mlumobi/uwm-indoor-localization-project/README.md

# UWB TDoA Real-time Localization

An EC601 course project to build and evaluate an indoor location system for tagged objects using ultra wideband (UWB) radio and uplink time difference of arrival (TDoA).

This is a one-person project. Mingjin Lu is responsible for hardware integration, firmware, localization software, evaluation, and documentation, with AI assistance.

**Status:** Proposal stage. This repository currently contains the project proposal and reference documents. Firmware, localization software, and measured performance results are not yet included. Accuracy, update rate, and reliability values below are proposed targets, not demonstrated capabilities.

## Five Ws and How

| Question | Project definition |
| --- | --- |
| **What** | An indoor monitoring prototype for tagged robots and vehicles, with a live 2D map, distinct tag IDs, position freshness and validity indicators, configurable safety zones, alerts for non-permitted zone entry, abnormal motion and prolonged signal loss, and recorded-movement replay. The physical prototype targets two tags and three anchors; additional tags may be simulated and clearly labeled. |
| **Who** | The primary target user is a warehouse or factory safety manager overseeing a shared workspace with vehicles, people, robots, and machinery. A robotics engineer also needs to monitor a robot without integrating with its onboard navigation software. Mingjin Lu is the sole developer, with AI assistance; user needs and interface usefulness still require interviews. |
| **Why** | Help the user see where tagged robots or vehicles are, recognize restricted-zone entries and unreliable tracking information, and review past movement. Evaluate these monitoring functions against measured ground truth and scripted scenarios; improved workplace safety and attack detection are not established outcomes. |
| **When** | The Sprint 1 two-week demo will show a labeled Python simulation, purchase and delivery progress, and the hardware implementation plan. After parts arrive, bring up the hardware, validate anchor clock correction, demonstrate one physical tag, then add the second tag and evaluate tracking and alerts. |
| **Where** | The intended application is a shared warehouse or factory workspace. Initial physical evaluation will use a controlled, surveyed indoor test area with known tag height and mapped zone boundaries; assembly and electrical checks are planned at RASTIC. Industrial deployment requires separate validation. |
| **How** | Start with simulated UWB arrival timestamps to test localization, map display, alerts, and replay. For hardware, use DWM3000 modules with XIAO ESP32C3 controllers: tags broadcast uplink blinks, three anchors record receive timestamps, and a computer corrects anchor clocks using periodic anchor-to-anchor UWB two-way exchanges, calculates TDoA positions, and applies the monitoring rules. Wi-Fi forwards records. Retain position and alert logs, compare accuracy and delay with ground truth, and use tag-to-anchor TWR as the fallback if clock correction fails its timing criteria. |

## Planned demonstration

- Two tags and three fixed anchors, each using a DWM3000 UWB module with an ESP32 or another compatible microcontroller.
- A controlled 2D test area with surveyed anchor positions and known tag height.
- Wi-Fi forwarding of timestamp records to a central computer; Bluetooth remains an option to evaluate.
- A live map with tag IDs, position age, and invalid or stale states.
- Raw measurement logs and replayable evaluation results.

Qorvo lists the DWM3000 for TWR and TDoA tag or anchor use, with a customer-supplied MCU. The module does not integrate Bluetooth, so any Bluetooth connection must come from another component. These specifications support the proposed architecture but do not establish this prototype’s performance. [Qorvo DWM3000](https://www.qorvo.com/products/p/DWM3000)

## Localization architecture

```text
Two UWB tags
    │ UWB broadcasts with tag ID and sequence number
    v
Three fixed anchors
    │ Hardware arrival timestamps and receive diagnostics
    │ Wi-Fi backhaul
    v
Central computer
    Clock correction -> frame matching -> TDoA solver -> map and logs
```

In uplink TDoA, anchors observe the same tag transmission. Differences in its arrival times correspond to differences in path lengths. Anchor clock synchronization or correction is essential; Wi-Fi or Bluetooth transports the records and does not, by itself, establish the required UWB timing basis. The proposed records therefore contain **arrival timestamps**, rather than independently measured tag-to-anchor distances. [ESP32 and DWM3000 study](https://arxiv.org/html/2403.10194v1)

**Recommended first experiment:** Verify that the selected boards and driver can produce consistent, corrected timestamps before building the full interface. A published ESP32/DWM3000 system uses two-way ranging (TWR); it provides hardware precedent but does not validate my uplink TDoA design. TWR may serve as a hardware baseline or an explicitly labeled fallback. [ESP32 and DWM3000 study](https://arxiv.org/html/2403.10194v1)

Three anchors provide two independent time differences for a known-height 2D model. This is a minimal configuration with no extra measurement redundancy; it does not guarantee a unique or well-conditioned position. A fourth anchor is a recommended improvement if resources allow. Anchor placement and obstructed radio paths must be evaluated because both affect TDoA localization quality. [Sensor placement study](https://arxiv.org/abs/2204.04508)

## Proposed evaluation targets

These targets require confirmation after user interviews and the initial timing experiment.

| Measure | Proposed criterion |
| --- | --- |
| Static horizontal accuracy | Median error ≤0.30 m and 95th-percentile error ≤0.75 m across nine surveyed test positions. |
| Valid-position ratio | At least 95% of scheduled tag transmissions produce accepted positions, reported separately for each tag. |
| Tag transmission rate | Start at 10 Hz per tag and report the achieved valid-position update rate. |
| Stale-state detection | Mark a position stale within one second of the last accepted estimate. |
| Reproducibility | A reviewer can replay retained records and reproduce the reported metrics using the documentation. |

Calibration and evaluation data should be separated. Report missed transmissions, rejected estimates, per-position errors, and obstructed-path results. Human tracking, robot control, free-height 3D localization, and industrial deployment remain outside the initial demonstration.

## Development plan

1. Interview prospective users, confirm hardware and course dates, and test a paper map.
2. Verify board communication and anchor clock correction; create a clearly labeled recorded-data demo.
3. Demonstrate one live tag end to end, then evaluate the surveyed area.
4. Add the second tag and test identity, update behavior, and failure states.
5. Publish reproducible measurements and document failed criteria and limitations.

The proposal contains five user stories with acceptance criteria, an INVEST review, thin demo slices, and ranked assumptions with tests and pivot criteria. No feasibility test results are available yet.

## Repository contents

```text
README.md
proposal/
    UWB_Project_Proposal.docx
    UWB_Project_Proposal.pdf
ref/
    DWM3000 Data Sheet.pdf
    HID-whitepaper-UWB-guide-for-decision-makers.pdf
    qorvo-getting-back-to-basics-with-ultra-wideband-uwb-white-paper.pdf
```

- [Project proposal — Word](proposal/UWB_Project_Proposal.docx)
- [Project proposal — PDF](proposal/UWB_Project_Proposal.pdf)
- [DWM3000 data sheet](ref/DWM3000%20Data%20Sheet.pdf)
- [HID UWB whitepaper](ref/HID-whitepaper-UWB-guide-for-decision-makers.pdf)
- [Qorvo — Getting Back to Basics with Ultra-Wideband (UWB)](ref/qorvo-getting-back-to-basics-with-ultra-wideband-uwb-white-paper.pdf)

The HID whitepaper is retained as a background reference; it was not used as evidence in the current proposal. Setup and execution instructions will be added when runnable software is available.

## Sources and course guide

- [EC601_Sprint1](https://docs.google.com/presentation/d/1xGqi0pRQQJJB1kcCf-J-DX_ZKf9MRdXoSHOy6zalLVk/edit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) — recurring reference for this project's Sprint 1 plan. When referring to the "Sprint 1 slides" or "EC601_Sprint1," use this deck. Slide 2 lists the required plan sections, including the primary target user.
- [EC601 Defining Your Project](https://docs.google.com/presentation/d/1mjnqe2xNa9wXm628SlQiQ_eo9ZSn7dLjxyB_iZE9pWU/edit) — project definition, mission, users, stories, INVEST, thin slicing, and assumption testing.
- [Qorvo DWM3000 product information](https://www.qorvo.com/products/p/DWM3000) — component capabilities and intended applications.
- [Qorvo, Getting Back to Basics with Ultra-Wideband (UWB), May 2021](ref/qorvo-getting-back-to-basics-with-ultra-wideband-uwb-white-paper.pdf) — manufacturer white paper explaining UWB timing principles and TWR, TDoA, reverse TDoA, and PDoA topologies. Its TDoA discussion informs the planned synchronized-anchor architecture; general performance claims do not establish this prototype's accuracy, update rate, or battery life.
- [Espressif ESP32-C3 Series Datasheet](https://www.espressif.com/sites/default/files/documentation/esp32-c3_datasheet_en.pdf) — MCU radio and peripheral capabilities for the selected XIAO ESP32C3 controller; read alongside Seeed's board guide.
- [Krebs and Herter, 2024](https://arxiv.org/html/2403.10194v1) — an ESP32/DWM3000 TWR prototype and its measured limitations.
- [Zhao, Goudar, and Schoellig, 2022](https://arxiv.org/abs/2204.04508) — TDoA sensor placement and obstacle-induced measurement bias.

External technical claims should be supported by sources. Design recommendations, assumptions, and measured project results should remain distinguishable throughout development.

## AI collaboration

This one-person project is developed in collaboration with an AI agent, following the EC601 course guidelines. AI assistance is used for research, drafting, design review, and development support. The sole project owner remains responsible for verifying sources, testing implementations, and reporting results accurately.
