mlumobi/uwm-indoor-localization-project/sch/uwm_esp32/uwm_esp32.kicad_pcb

## KiCad design sch/uwm_esp32/uwm_esp32.kicad_pcb (2026-10-27)

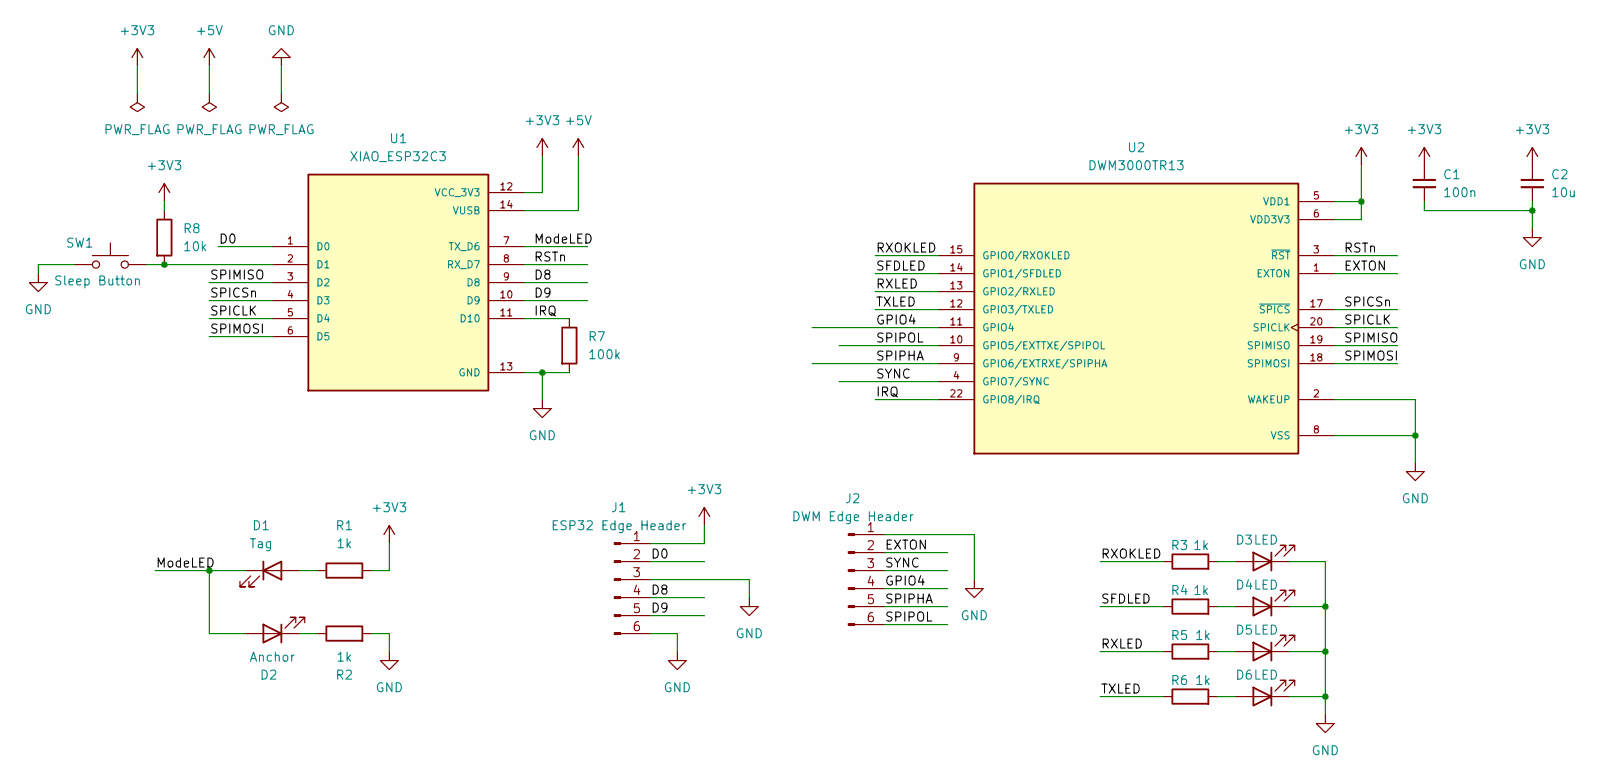
[picture p1: schematic uwm_esp32.kicad_sch, UWB ESP32 Tag/Anchor]

Parts:
C1: 100n; C_0805_2012Metric_Pad1.18x1.45mm_HandSolder
C2: 10u; C_0805_2012Metric_Pad1.18x1.45mm_HandSolder
D1: Tag; LED_0805_2012Metric_Pad1.15x1.40mm_HandSolder
D2: Anchor; LED_0805_2012Metric_Pad1.15x1.40mm_HandSolder
D3, D4, D5, D6: LED; LED_0805_2012Metric_Pad1.15x1.40mm_HandSolder
J1: ESP32 Edge Header; PinHeader_1x06_P2.54mm_Vertical
J2: DWM Edge Header; PinHeader_1x06_P2.54mm_Vertical
R1, R2, R3, R4, R5, R6: 1k; R_0805_2012Metric_Pad1.20x1.40mm_HandSolder
R7: 100k; R_0805_2012Metric_Pad1.20x1.40mm_HandSolder
R8: 10k; R_0805_2012Metric_Pad1.20x1.40mm_HandSolder
SW1: Sleep Button; SW_SPST_Omron_B3FS-101xP
U1: XIAO_ESP32C3; MODULE_XIAO_ESP32C3; PARTREV 23/05/2022
U2: DWM3000TR13; XCVR_DWM3000TR13; PARTREV B

Connections:
+3V3: C1.1, C2.1, J1.1, R1.2, R8.1, U1.12 (VCC_3V3), U2.5 (VDD1), U2.6 (VDD3V3), U2.7 (VDD3V3)
+5V: U1.14 (VUSB)
/D0: J1.2, U1.1 (D0)
/D8: J1.4, U1.9 (D8)
/D9: J1.5, U1.10 (D9)
/EXTON: J2.2, U2.1 (EXTON)
/GPIO4: J2.4, U2.11 (GPIO4)
/IRQ: R7.1, U1.11 (D10), U2.22 (GPIO8/IRQ)
/ModeLED: D1.1 (K), D2.2 (A), U1.7 (TX_D6)
/RSTn: U1.8 (RX_D7), U2.3 (~RST)
/RXLED: R5.1, U2.13 (GPIO2/RXLED)
/RXOKLED: R3.1, U2.15 (GPIO0/RXOKLED)
/SFDLED: R4.1, U2.14 (GPIO1/SFDLED)
/SPICLK: U1.5 (D4), U2.20 (SPICLK)
/SPICSn: U1.4 (D3), U2.17 (~SPICS)
/SPIMISO: U1.3 (D2), U2.19 (SPIMISO)
/SPIMOSI: U1.6 (D5), U2.18 (SPIMOSI)
/SPIPHA: J2.5, U2.9 (GPIO6/EXTRXE/SPIPHA)
/SPIPOL: J2.6, U2.10 (GPIO5/EXTTXE/SPIPOL)
/SYNC: J2.3, U2.4 (GPIO7/SYNC)
/TXLED: R6.1, U2.12 (GPIO3/TXLED)
GND: C1.2, C2.2, D3.1 (K), D4.1 (K), D5.1 (K), D6.1 (K), J1.3, J1.6, J2.1, R2.2, R7.2, SW1.1, U1.13 (GND), U2.2 (WAKEUP), U2.8 (VSS), U2.16 (VSS), U2.21 (VSS), U2.23 (VSS), U2.24 (VSS)
unnamed: D1.2 (A), R1.1
unnamed: D2.1 (K), R2.1
unnamed: D3.2 (A), R3.2
unnamed: D4.2 (A), R4.2
unnamed: D5.2 (A), R5.2
unnamed: D6.2 (A), R6.2
unnamed: R8.2, SW1.2, U1.2 (D1)

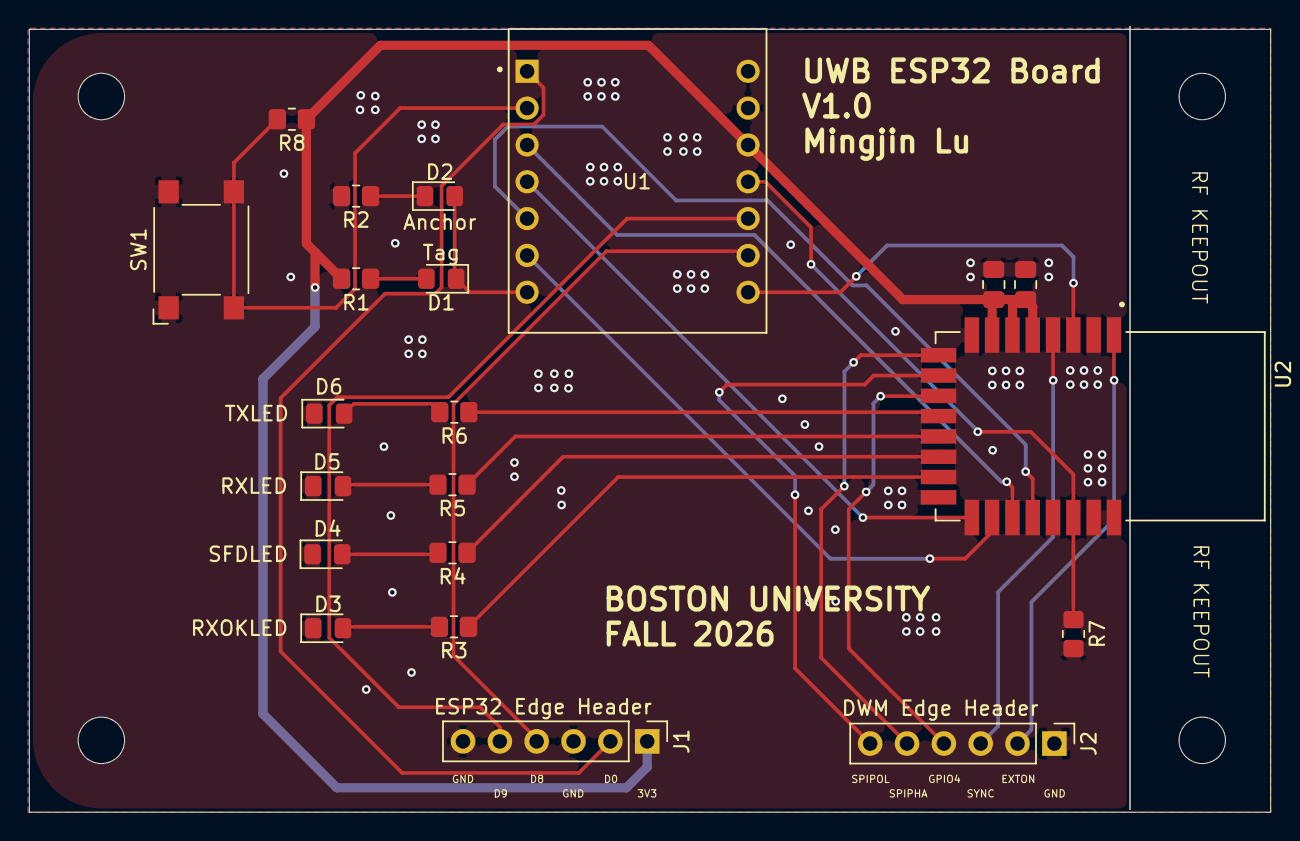
[picture p2: board uwm_esp32.kicad_pcb from above]

Board: 2 copper layers, 85.6 x 54.0 mm, 21 parts (0 on the bottom side), 28 nets.
