mlumobi/uwm-indoor-localization-project/(commit log)

2026-10-02 Add project proposal and expand README
    Add project proposal files (proposal/UWB_Project_Proposal.docx and .pdf) and substantially expand README.md with a full project overview: goals, planned demonstration, localization architecture, evaluation targets, development plan, repository contents, sources, and AI collaboration note. Marks repository status as proposal stage and documents recommended first experiments and assumptions.
2026-10-02 Add Sprint 1 plan and mission statement
    Create Sprint/SPRINT1.md with the Sprint 1 Plan and mission: introduce the UWB Indoor Localization Project as a prototype to track multiple indoor mobile robots using attachable UWB tags, displaying positions and data freshness to support heterogeneous robot platforms and simplify tracking setup.
2026-10-06 Add Sprint 1 project plan
    This commit adds the Sprint 1 planning materials for the UWB indoor localization project. It updates the project README with the required sprint reference link, creates the faculty and team placeholders, and expands the sprint plan with target user, feasibility, tooling, demo scope, and risk sections to align with the course requirements.
2026-10-13 Clarify sprint assumptions and scope
    This update refines the Sprint 1 plan in SPRINT1.md by tightening the user-story acceptance criteria, rephrasing demo commitments to emphasize the author’s responsibility, and adding a detailed project-assumption section. It highlights the critical uplink TDoA timing assumption, defines feasibility gates and go/no-go criteria, and documents the preferred fallback path if anchor synchronization cannot meet the required timing targets.
2026-10-13 Clarify README TDoA framing and hardware docs
    This commit updates the README to describe the uplink TDoA design as the author's proposed design rather than a general claim. It also replaces the generic ESP32 datasheet reference with the ESP32-C3 datasheet and board-specific guidance for the selected XIAO ESP32C3 controller to better match the target hardware.
2026-10-13 Update sprint docs and add faculty list
    This commit adds a faculty relevance brief for the UWB indoor localization project, highlighting three BU professors whose research connects to uncertainty, safety, and practical evaluation. It also extends the sprint summary with a final risk and ethics note, and removes the obsolete TEAM.md file from the sprint materials.
2026-10-14 Add Qorvo UWB whitepaper and update docs
    Add Qorvo 'Getting Back to Basics with Ultra-Wideband (UWB)' whitepaper (ref/qorvo-getting-back-to-basics-with-ultra-wideband-uwb-white-paper.pdf) and update README.md and Sprint/SPRINT1.md to reference it. Increment reference count from eight to nine and clarify the whitepaper's role informing TDoA/TWR architecture while noting vendor claims are background context, not measured prototype results.
2026-10-15 Define safety monitoring prototype scope
    Update the project and Sprint 1 mission to target warehouse and factory safety managers, with zone and motion alerts, signal-loss warnings, and movement replay. Clarify the simulation-first demo, hardware rollout, evaluation criteria, and limits on safety claims.
2026-10-15 Update firmware plan and add UWB site archive
    Revise the Sprint 1 plan to use ESP-IDF for XIAO ESP32C3 firmware and treat the Makerfabs driver as a reference for porting. Add the UWB site archive.
2026-10-27 Add ESP32C3 and DWM3000 KiCad design
    Add a preliminary KiCad schematic and PCB project with custom symbols and footprints for the XIAO ESP32C3 and DWM3000TR13. Include a wiring reference covering pin assignments, power, buttons, and current-limited LED circuits.
2026-10-27 Add IRQ pull-up to ESP32 schematic
    Replace the mode button with a 100k IRQ pull-up, add a test point, and set the capacitor values to 10uF and 100nF.
2026-10-27 Add sleep button pull-up circuitry
    Add a 10 kΩ resistor and +3V3 connection, reposition the sleep button and TP8, and update the related wiring and labels.
2026-10-27 docs: sync UWB connections with updated KiCad schematic
2026-10-27 Add ESP32 and DWM edge headers
    Replace test points with six-pin edge headers, connect the ESP32-C3 and DWM3000 signals, and update the PCB layout with the module and supporting components.
2026-10-27 docs: document expansion headers and latest schematic review
2026-10-27 Revise ESP32 UWB board layout
    Reposition and lock components, add M3 mounting holes, antenna keepout, and silkscreen labels. Update PCB design settings.
2026-10-27 pcb: enlarge XIAO header drills to 1.0 mm and pads to 1.6 mm
2026-10-27 Adjust ESP32 PCB component placement
    Reposition and rotate C1/C2, increase the through-hole pad drill to 1 mm, and update the PCB pad-size defaults.
2026-10-27 pcb: restore 1.0 mm XIAO drills and 1.6 mm pads after placement update
2026-10-27 Route ESP32 board and add ground pour
    Add signal and power routing with vias and filled ground zones. Rotate and unlock R1 to match the updated layout.
2026-10-27 Adjust ESP32 board ground via placement
    Add and reposition GND stitching vias on the PCB, and update the saved KiCad layer and item visibility settings.
2026-10-27 Reroute ESP32 PCB connections
    Reworks SPI, GPIO, and 3.3 V routing, updates copper pours, and adjusts default pad dimensions in the KiCad project.
2026-10-27 Reroute ESP32 board D0 trace
    Rework the D0 route and refresh copper fills, including associated ground-via changes. Update the saved KiCad active-layer setting.
2026-10-27 Reroute ESP32 IRQ and SPI traces
    Update the IRQ, SPIPHA, and SPIPOL routing, relocate vias, remove two unused GND vias, and refresh the F.Cu zone fills.
2026-10-27 Add KiCad schematic lock file
    Add the schematic editor lock file, recording the host and username associated with the active editing session.
2026-11-12 Update ESP32 schematic resistor values
    Set six resistors to 330 Ω and add a dated schematic backup.
